RX5950XT/3DP-Toothbrush_shaver_holder/previews/bottom.png

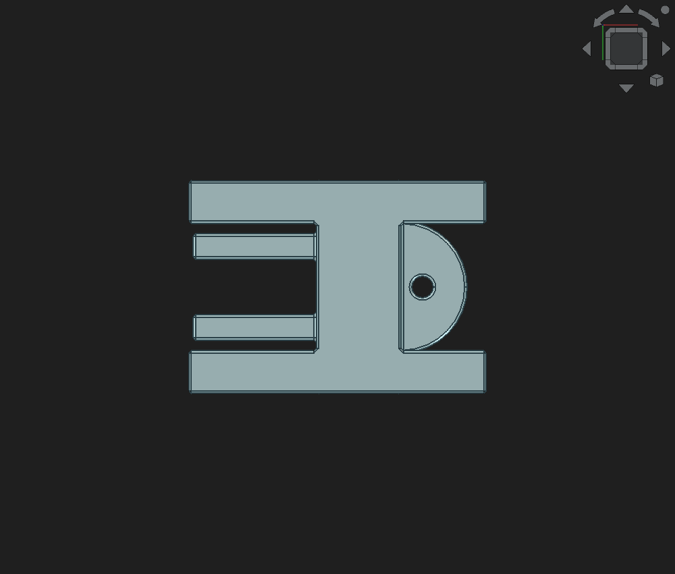
previews/bottom.png
