RX5950XT/3DP-Toothbrush_shaver_holder/previews/front.png

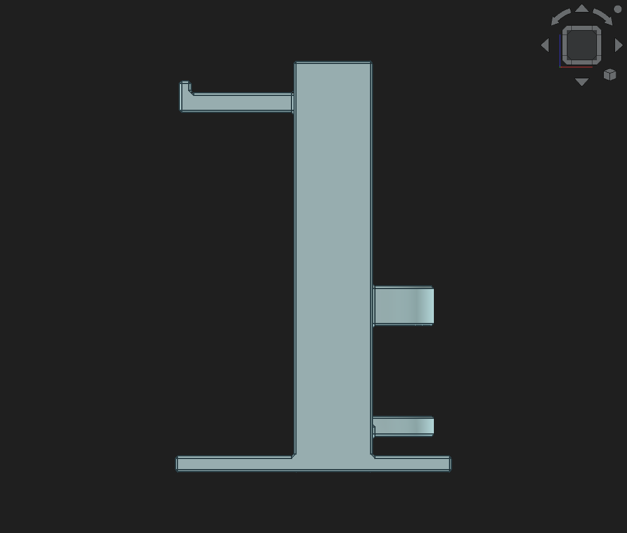
previews/front.png
