RX5950XT/3DP-Toothbrush_shaver_holder/previews/left.png

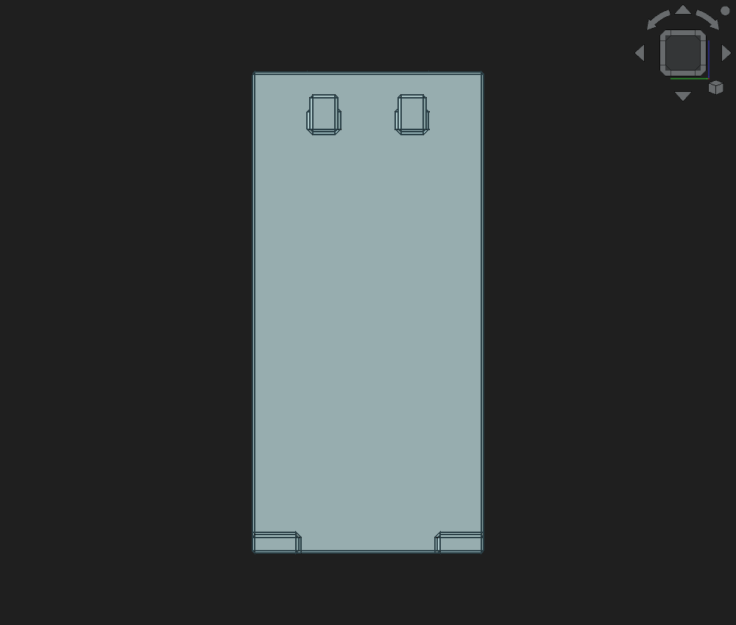
previews/left.png
