RX5950XT/3DP-Toothbrush_shaver_holder/models/toothbrush_shaver_holder_v2.step

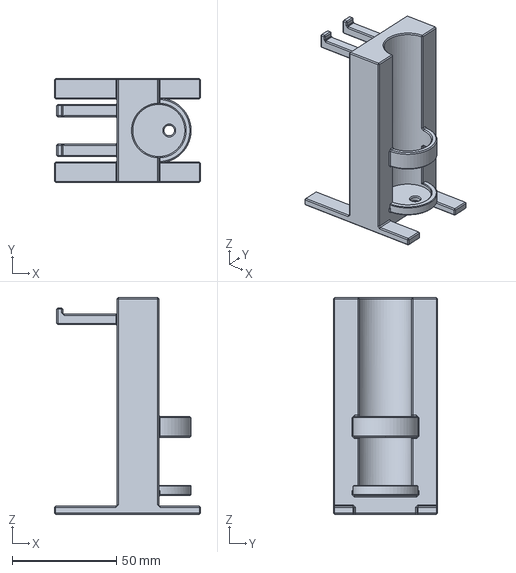
[picture p5: CAD file, 2026-10-16]
models/toothbrush_shaver_holder_v2.step
70.0 x 50.0 x 104.0 mm
