RX5950XT/3DP-Toothbrush_shaver_holder/(list of files, cad)

Other CAD files:
print/holder_v2_A1_PETG.3mf
models/ToothbrushShaverHolder.FCStd
print/toothbrush_shaver_holder_v2.stl
