RX5950XT/3DP-Toothbrush_shaver_holder/(commit log)

2026-10-16 chore: publish validated toothbrush and shaver holder v2
    [ToothbrushShaverHolder.FCStd, holder_v2_A1_PETG.3mf, machine.json, toothbrush_shaver_holder_v2.step, toothbrush_shaver_holder_v2.stl]
2026-10-23 docs: note the holder has been printed and fits
    Claude-Session: https://claude.ai/code/session_01QrsK5Numt2wSY1yZYYGFop
